ShellAlbert/PSU_Hirose_Version/README.md

# PSU_Hirose_Version
Power Supply Unit using Hirose Extensible Connector Version
