ShellAlbert/PSU_Hirose_Version/PSU_Hirose_Version/Schematic/SCH-PSU-Hirose.pdf

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
Here Vnormal=3.3V, Vcutoff=1.8V, t=10 seconds, I=100mA. C=[(Vnormal+Vcutoff)*I*t] / [(Vnormal^2-Vcutoff^2)] C=[(3.3+1.8)*0.1*10] / [3.3^2-1.8^2]=0.667F

## Farad Capacitor

The output voltage can be adjusted between 1.6V and 5.25V. Vout=1.004V*(R1/R2+1)=1.004V*(1M/270K+1)=4.72V

### LTC3105 400mA Step-Up DC/DC Converter Auxiliary 6mA LDO Regulator

Photovoltaic Cell

Photovoltaic Cell

VIN PIN
When used with high impedance sources such as photovoltaic cells, this pin should have a 10uF or larger decoupling capacitor.

MPPC PIN
Connect a resistor from MPPC to GND to program the activation point for MPPC loop. To disable the MPPC circuit, connect MPPC directly to GND.
VMPPC=10uA*RMPPC
=10uA*200K
=0.01mA*200K
=0.01A*200
=2V

THIS RESISTOR IS USED TO BYPASS AMP.

P5V0

### Vout=1.2V*(1+R2/R1) =1.2V*(1+1M/309K)

=5.08V

LTC3539
2A 1MHz Synchronous Step-Up DC/DC Converters VIN=0.7V~5V

## GAIN=1

ADA4051-1
1.8V,Micropower,Zero-Drift,
Rail-to-Rail Input/Output Op Amps 1/2Vcc | Input Independance >> 1M 1/3Vcc ADJ

## VCMP

# Open-Drain

## VCMP

OR

## OR Y=A|B

## AND Y=A&B

BIAS

Make sure IO is in tri-state during power up.

### MODE = High: Burst Mode operation at light loads, >=0.88V MODE = Low: Fixed frequency PWM Mode, <0.3V

CAUTION: No Polarity Protection Circuit Designed ! DIODES OR MOSFETS WILL CAUSE VOLTAGE DROP.

# IVC AMP

# BYPASS NOT

# CMP

LDO 2.2V/6mA
LDO22-1: UNIT GAIN AMP, HYSTERESIS VOLTAGE COMPARATOR, AND GATE LDO22-2: HYSTERESIS VOLTAGE COMPARATOR+OR GATE, OR GATE

OR

### AND

LED turns on at
I=(5.0-2.2)/56K=50uA

Vin_rise=Vref*(R1+R2)/R2
=1.0V*(160+300)/300
=1.53V

Vin_fall=(Vref*(R1+R2+Rpullup)-Vsupply*R1)/(R2+Rpullup) =(1.0v*(160+300+10000)-(2.2V*160))/(300+10000) =0.98

Since there's a 1/3 voltage divider before input,
the realistic action voltage are as follow ing Vin_rise=1.53V*3=4.59V
Vin_fall=0.98V*3=2.94V

Vin_rise=Vref*(R1+R2)/R2
=1.0V*(1000+5100)/5100
=1.2V

Vin_fall=(Vref*(R1+R2+Rpullup)-Vsupply*R1)/(R2+Rpullup) =(1.0v*(1000+5100+20000)-(2.2V*1000))/(5100+20000) =0.95V

Since there's a 1/2 voltage divider before input,
the realistic action voltage as follow ing Vin_rise=1.2V*2=2.4V
Vin_fall=0.95V*2=1.9V

# 1.9V(FALL) 2.4V(RISE)

# 2.94V(FALL) 4.59V(RISE)

L=Vout*(1-D)*T/(CR*Iout)
=5.0*(1-50%)*1uS/(30%*200mA) =4.2uH

Vfd=1.23V

Ve

R2

R1

R4

R3

Re

Rin

Appropriate Parameters
Case 1: R1=R2=R3=510, R4=560, Re=51, Rin=5.1K Case 2: R1=R2=R3=1K, R4=1.2K, Re=62, Rin=8.2K

CDONE,
Open-drain Output Configuration Done output. With weak pullup resistor to VCCIO_X.

# 1.8V IO

# SPI PROGRAMMING INTERFACE

# sysCONFIG Port / Pins

Horizontal-Short to Program Flash Vertical-Short to Program iCE

# OPEN-DRAIN PULL-UP

The sysCONFIG pins are dual function,
meaning they can be recovered as user I/O after configuration is complete.

# BUFFERING Octal RAM

2.0V

# ECL DRIVER CONNECT TO TMR/DPU DPU 1.8V IO

# POWER TO DPU

# RECEIVE: IVC->AMP->CMP

# OFFSET=1/2VCC

VTH SETTING

The maximum source/sink current of IOs are 4mA.

## (1.8V IO)

## (1.8V IO)

## (1.8V IO)

EXCLUSIVE
LD_PWR_EN FOR TMR
LD_PWR_EN_EXT FOR DPU

EXCLUSIVE
PSU_UART_TX FOR TMR
DPU_UART_TX FOR DPU

EXCLUSIVE
PSU_UART_RX FOR TMR
DPU_UART_RX FOR DPU

TMR SENSOR NEEDS 3.3 V POWER SUPPLY. DROP DOWN TO 2.8V IF IT'S COMPATIBLE.

Inductor peak current automatic adjusting to maximize efficiency 100mA at light load, 500mA at heavy load,
100mA to 500mA at intermediate loads.
This function is overridden by MPPC function.
Theoretically, maximum power output of photovoltaic cell is 250mW.
If we set VMPPC to maintain 2V, the peak inductor current is 250mW/2=125mA.

The MPPC circuit dynamically regulates the average inductor current to prevent the input voltage from dropping below the MPPC threshold. When Vin is greater than the MPPC voltage, the inductor current is increased until Vin is pulled down to the MPPC set point.
If Vin is less than the MPPC voltage, the inductor current is reduced until Vin rises to the MPPC set point.

LC LOW PASS FILTER
f-cutoff=1/(2*pi*sqrt(L*C)) =1/(2*3.1415*sqrt(10uH*22uF)=1073Hz

0R

0R

Jumpers used to cut off power supply of FPGA if it’s useless in realistic application.

# LTC3539 BOOST

P5V0

# MAX38650 BUCK

P1V8

# LTC3542 BUCK

# LTC3542 BUCK

# LASER DIODE TX&RX (ADJ)

# SENSOR(5V0) TMR(3V3) ULTRASONIC(3V3)

# iCE40UP5K FPGA

P2V8

# MAX38650 BUCK

P2V8

P1V8

### CONNECT TO VCAP

TO GET HIGHER EFFICIENCY.

P1V2

Estimate the maximum output current is 30mA, and the ripple current is 0.4*30mA=12mA, then L=Vout/(f*Delta IL)*(1-Vout/Vin(max))=2.8/(2.25*0.012)*(1-2.8/5)=45.6uH
L=Vout/(f*Delta IL)*(1-Vout/Vin(max))=3.3/(2.25*0.012)*(1-3.3/5)=41.6uH

## Vfd=2.2V

P5033

LED turns on at
I=(2.8-2.2)/12K=50uA

Vout=0.6V*(1+R2/R1)
=0.6V*(1+150K/33.2K)
=3.3V

# MAX38650 BUCK

P1V2

# P2V9ADJ

Vout=0.6V*(1+R2/R1)
=0.6V*(1+150K/39K)
=2.9V

LTC3542 Maximum Output Current is 500mA
A reasonable starting point for setting ripple current is Deal_IL=0.4*Iout(Max)=0.4*500=200mA The largest ripple current occurs at the maximum input voltage.
L=Vout/(f*Delta IL)*(1-Vout/Vin(max))
=1.8/(2.25*0.2)*(1-1.8/5)
=2.56uH
Actually we estimate the maximum output current is 30mA, and the ripple current is 0.4*30mA=12mA, then L=Vout/(f*Delta IL)*(1-Vout/Vin(max)) =1.8/(2.25*0.012)*(1-1.8/5)
=42.6uH RUN PIN
>1.5V: Enabled.
<0.3V: Disabled.

Enable Bypass Resistor to distribute P5V0.

P5033

# P2V9ADJ

# LOAD SWITCH

VFD=0.37V@20mA

RATING POWER OF DIFFERENT FOOTPRINTS 0402 : 1/16W (0.0625w)
0603 : 1/10W (0.1W)
0805 : 1/8W (0.125W)

H/C Type
Compatible
2F/5.5V

H/C Type
Compatible
2F/5.5V

### REMOVE R17 TO CUT OFF

ICE40 POWER SUPPLY.

# FRONT PANEL LED

UV_SHDN determines how low voltage the Farad capacitor can discharge. In heavy load application like cameras, slow down trigger voltage threshold. Present State:
UV_SHDN=1, Vin_rise=1.2V, Magnification Factor=2, 1.2V*2=2.4V, Vin>2.4V UV_SHDN=0, Vin_fall=0.95V, Magnification Factor=2, 0.95V*2=1.9V, Vin<1.9V Optimization:
My motivation is to slow down magnification factor from 2 to 1.1
Change Magnification Factor=1.1
Vin_rise=1.2V, 1.2V*1.1=1.32V
Vin_fall=0.95V, 0.95V*1.1=1.04V
For magnification factor=2, ½, R2/(R1+R2)=1/2, we choose R1=R2=1M-OHMS. For magnification factor=1.1, 1/1.1, R2/(R1+R2)=1.1, we choose R2=1M, get R1=? 1M/(R1+1M)=1.1, 1M/1.1=R1+1M, R1+1M=909090.90, R1=-90909.10
R1 is negative value !!!!!!
So the only way is to replace ADCMP380-1(1.0V VREF) with ADCMP3890-2(0.5V VREF). Vin_rise=Vref*(R1+R2)/R2=0.5V*(1000+5100)/5100=0.6V Vin_fall=(Vref*(R1+R2+Rpullup)-Vsupply*R1)/(R2+Rpullup) =(0.5*(1000+5100+20000)-(2.2*1000))/(5100+20000)
=0.432V
If the magnification factor of front stage is still 2, the trigger voltages are Vin_rise_action=0.6V*2=1.2V
Vin_fall_action=0.432V*2=0.864V
But the second boost converter LTC3539 can only work over 0.7V, this should grab our attention.

# CHARGING INDICATOR

# ADCMP380-1ACBZ-RL7, VRef=1.0V ADCMP380-2ACBZ-RL7, VRef=0.5V

# External Oscillator 12MHz->PLL->48MHz

IAM_ALIVE
IAM_ALIVE_EXT

IO_P5V0_SHDN_EXT

IO_P5V0_SHDN

PSU_UART_RX

DPU_UART_RX

## P1V8_DPU

## P2V8_DPU

## P3V3_DPU

LDO22-1

LDO22-2 VCAP

LDO22-2 VCAP

LDO22-2

LDO22-2

LDO22-2

LDO22-2 | LDO22-1
LDO22-1 | P1V8_RX

P1V8_RX

P1V8_RX

P1V8_RX

LDO22-1

VCAP

P1V20 | SPI_VCCIO1 P1V80 | P1V80 P1V20 | P1V80 P2V8 | P1V80 P1V80 VCCIO_0 P1V80 | P1V80 VCCIO_2 | P1V80 P1V80 | P1V80 | P1V80 P5V0

P2V8

P1V8 | P1V80 P1V2 | P1V20 P1V20
LDO22-1 | P¹V⁸_RX

P1V8_RX

P5V0

VCAP1 VCAP2 | P5V0 | P2V8 P1V8 P5V0 P5V0 P5V0 | P1V2 | P5033 P5V0 | P5033_PRE
P5V0 | P2V9ADJ P1V8ADJ_PRE

P2V9ADJ

P1V80 P2V9ADJ | P1V8_RX

VCAP

P5V0 VCAP

LDO22-2

P1V80 | P1V80
P5V0 | P5V0
P1V80 | P2V8 P1V80 P1V20 | P1V80
P5033 P2V8 | DPU_PWR_EN

DPU_PWR_EN

Title Size | Document Number | Rev Date: | Sheet | of PoF TINY DUAL CAMERA PROJECT | C2 PART ONE - POWER SUPPLY UNIT SCHEMATIC
A2 | Friday, September 26, 2025 | 1 | 1 Title Size | Document Number | Rev Date: | Sheet | of PoF TINY DUAL CAMERA PROJECT | C2 PART ONE - POWER SUPPLY UNIT SCHEMATIC
A2 | Friday, September 26, 2025 | 1 | 1 Title Size | Document Number | Rev Date: | Sheet | of PoF TINY DUAL CAMERA PROJECT | C2 PART ONE - POWER SUPPLY UNIT SCHEMATIC
A2 | Friday, September 26, 2025 | 1 | 1

D5GREEN LED R³⁰ DNI

TP2 C510uF C78

22uF C6810uF | R31 | 0 | R113

10K

R128 DNP | Q6 | MMBT2222ALT1G

FB3

BLM15PX121SN1D

L8

2.2uH

C42 | 0.1uF
TP15 | R89 33.2K

U17

SN74LVC1G32DBVR 1 | C10096 A

### 2 B

### 3 GND

### 4 Y

### 5 VCC

R108 0

R36

200K

# C47 0.1uF R41 1M

R114 6.8K

C8 CEN5R5205HF-ZG

1 2

3 4

R26 | 10K | C49

10uF C56

0.1uF

# TP12 R62

270K

R67 0

C35

10uF

L6 | 10uH/1A C177242 | R80 DNI
R6 | 1K

R47
1M | R⁵⁴ 4.7K

R58
510

C26

10uF | C90.1uF

L11 47uH/100mA

# J3 CONN-2X15P

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
D3GREEN LED

R101 10K

U22 | SN74LVC1G32DBVR

C10096 1 A

### 2 B

### 3 GND

### 4 Y

### 5 VCC

C17
0.1uF

R33 150K R¹⁰⁶

0

C43

0.1uF | R103 DNP C100.1uF
R102 10K | R130 DNP

Y1 12.0MHz EN

### 1 GND

### 2 OUT

### 3 VCC

4 R82 | 0 R¹⁵ 0 | D4 GREEN LED
C130723 R46 | 0

Q4

BFR93AWH6327 | B1

### 3 C

2E

# TP8 Solar Cell V- R42

2M

R110 10K R120 11.8K

TP4

TP6 | R127 | 0 Q1 | MMBT2222ALT1G

R8
51

U1 TXS0102DCUR
B2

### 1 GND 2 VCCA 3 A2 4 A1

### 5 OE

### 6 VCCB

7 B1 C4 | 8 10uF

U21 LTC3539EDCB-2#TRPBF SW

### 1 PGND

### 2 GND

# 3 VIN

### 4 SHDN

### 5 FB

### 6 MODE

### 7 VOUT

### 8 EPAD

### 9 C62

0.1uF

R3 | 0 | C79
| | 47uF

R48
270K

R28 0

R87 0

L9 | 2.2uH
R83 | 12K
R99 DNI | C63 | 0.47uF
L7 | 2.2uH
R93 | DNP
L10 | 4.7uH/200mA | R78 0 C36
1uF | R123 0 R60

20K R90

10K

R86 DNI

R38
1M
L3 | 2.2uH/200mA R27 | DNI

R52

### 51 D6 GREEN LED

C130723

R91 100K

C65
0.1uF

TP7 C20

47uF

R75 | 0 | R¹¹⁸
U20 | DNI

SN74AUP1G08DBVR

C139409 VCC

### 5 GND

### 3 A

### 1 B

### 2 Y

4 | R68 | DNP | C22 | 22pF
R95 | 2.2K
R50 | 100K

R121 DNP R61

200K

R21 | 0 | R25 | DNP

C60.1uF

Q7 MMBT2222ALT1G

C37

0.1uF | C25 | 0.1uF

TP9 Solar Cell V+

R22 DNP

C14

47uF

R23 DNP

Q2 MMBT2222ALT1G

## FB5BLM¹⁵PX¹²¹SN¹D

R17 | DNP | C73 | 1.5pF R112 1K | C64

0.1uF

R51 | 1K | R⁹⁴ 10K R122 DNP

C7 CEN5R5205HF-ZG

1 2

3 4 R104 2K

R79 160

C45

10nF C27

10nF | R⁴ 20K | R7 | 1K
TP3 | R¹⁶ 0 | R10 | 0
C59

# 22uF U2

LTC3542ES6 VIN

### 1 GND

### 2 VFB

### 3 RUN

### 4 MODE/SYNC

### 5 SW

6

L12 0R

R129 DNP

TP10 Solar Cell V+

C19

47uF R88 150K

R56
1M
R115

# 1M R⁴⁴ DNI

C74

22uF

LD1 LaserDiode
LD+

1
LD- 2 | PD- | 3 PD+

4

D9 GREEN LED C130723

C40

22uF

C75

0.1uF

C71

10uF | U15 LTC3105EDD#PBF

FB

1

LDO

### 2 FBLDO

### 3 SHDN

### 4 MPPC

# 5 VIN

### 6 SW

### 7 PGOOD

### 8 VOUT

### 9 AUX

10 11 GND

R109

309K

R13 | DNP
R84 | 0 | C31
10nF C2910uF | R100 0
TP14 | R131 DNP
C60 | 0.1uF U13 | ADA4051-2ARMZ C160715

### 1 OUT A -IN A

2 +IN A
3

### 4 V-8 V+ OUT B 7

-IN B

6 +IN B

5

R63 | 0
R12 | 1K
FB4 BLM15PX121SN1D | R⁹⁷ 10K R126 DNP

# J2 CONN-1X8

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
0.1uF | R² 20K
D7 GREEN LED C130723 | R57 | 40.2K | C18
0.1uF | C53

0.1uF

R125 DNP

## FB2BLM¹⁵PX¹²¹SN¹D

R53 | DNP
R107 0 | R34 | DNP

C38

10nF

R32
39K
C46 | 2.2uF
R40 | 1K | R⁷³ 6.8K

C48

10uF C54 | 2.2uF | C2

0.1uF

REF

+

- U16 | ADCMP380-(1/2)ACBZ-RL7 A¹ VCC GND A² B1 EN | GND B²

IN

C1 | OUT C2
R70 | DNP

REF

+

- U18 | ADCMP380-(1/2)ACBZ-RL7 A¹ VCC GND A² B1 EN | GND B²

IN

C1 | OUT C2
R72 | 0 | C41 | 0.1uF C58

10uF U14 LTC3105EDD#PBF

FB

1

LDO

### 2 FBLDO

### 3 SHDN

### 4 MPPC

# 5 VIN

### 6 SW

### 7 PGOOD

### 8 VOUT

### 9 AUX

10 11 GND

R1

20K | C69

0.1uF R37
1M

R98

0

C13
0.1uF

C32

0.1uF

C70

33pF

R105 0 | C11
0.1uF C76 | 0.1uF

U6 W25Q32JVZPIQ/WSON-8 CS

1 | DO(IO1) 2 | WP(IO2) 3 | GND
DI(IO0) | 4

### 5 CLK

6 | HLD/RST(IO3) 7 | VCC

8

R66
510
C12 | 0.1uF
L4 | 2.2uH/200mA | R119 | 10K
TP13 | R117 0 R²⁰ 0 | R⁶⁴ 10K C44
0.1uF U9 | MAX38650AANT+ A²
IN | LX A1 | OUT B2 EN
B1 | RSEL | B3 A³ GND | R⁵ 20K | U11 OPA320AIDBVR OUT

### 1 V⁻ 2

IN+

3

IN- 4 V⁺

# 5 C51

10nF

J4 DF40HC(3.0)-70DS-0.4V(51)

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
22pF

R85
300 C16

0.1uF

C61

0.1uF

L1 47uH/200mA

TP1

R74 | 3.3K | R⁶⁹ 6.8K

C39

22pF

R76 | 3.3K | C3

10uF

U3 | MAX38650AANT+ A²
IN | LX A1 | OUT B2 EN
B1 | RSEL | B3 A³ GND
C55 | 22pF | R19 | DNP D1 GREEN LED
C130723 | R¹⁸ DNP
L5 | 10uH/1A C177242 R49
5.1K | D2GREEN LED

C66

10uF | C80 | DNP
C67 | 0.1uF

R45

510 Q3 MMBT2222ALT1G

C77

22uF

U19
LTC3542ES6 VIN

### 1 GND

### 2 VFB

### 3 RUN

### 4 MODE/SYNC

### 5 SW

### 6 R²⁹ DNP

R124 100K | U12

LMV7291MGX/NOPB VOUT

1 | V⁻ 2 | +IN

3

| | -IN

### 4 V⁺

# 5 iCE40UP5K - SG48Bank1 Bank0 Bank2

iCE40UP5K- SG48

U5

C2678152 | IOB_0A

46

IOB_2A

47
IOB_3B_G6

44

IOB_4A

48
IOB_5B

45

IOB_6A

2

IOB_8A

4
IOB_9B

# 3 CRESET_B

### 8 CDONE

7

IOB_13B

6

IOB_16A

9

IOB_18A

### 10 IOB_20A

11

IOB_22A

12
IOB_23B

21
IOB_24A

13
IOB_25B_G3

20
IOB_29B

19
IOB_31B

18

IOB_32A_SPI_SO

### 14 IOB_33B_SPI_SI 17 IOB_34A_SPI_SCK

### 15 IOB_35B_SPI_SS

### 16 VCCPLL

29

IOT_36B

### 25 IOT_37A

23

IOT_38B

### 27 IOT_39A

26

IOT_41A

28

IOT_42B

### 31 IOT_43A

32

IOT_44B

### 34 IOT_45A_G1

37

IOT_46B_G0

35

IOT_48B

### 36 IOT_49A

43

IOT_50B

### 38 IOT_51A

### 42 RGB0

### 39 RGB1 40 RGB2

# 41 GND 49 VCC

### 5 VCC

# 30 VCCIO_0

### 33 SPI_VCCIO1

# 22 VCCIO_2

### 1 VPP_2V5

### 24 R43

100R

# J5 CONN-2X15P

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
0.1uF | R116 0

Q5

BFR93AWH6327 1B

### 3 C

2E

C21

10uF

C1 | 0.1uF | R59 | 0

R111 DNP

R96 DNI

U4 APS25608N-OBR-BD
RST A4 | CE
A3 | | | | | | | | | CLK
B2 | A/DQ0 D3 | A/DQ1 D2 | A/DQ2 C4 | A/DQ3 D4 | A/DQ4 D5 | A/DQ5 E3 | A/DQ6 E2 | A/DQ7 E1 | DQS/SM
C3 | VDD
D1 VSS | C1 VDD

# E4 VSS

E5 NC.A2 | A2 NC.A5 | A5 NC.B1 | B1 NC.B3 | B3 NC.B4 | B4 NC.B5 | B5 RFU
C2 NC.C5 | C5

C23

10uF

R14 | 20K | R⁸¹ 10K

# J1 CONN-1X8

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
### 9 D8

1N5819WT

L2 2.2uH/200mA C34

10uF

## PD1Photodiode

1 2

R92 20K

U10 OPA320AIDBVROUT

### 1 V⁻ 2

IN+

3

IN- 4 V⁺

5

C33

1uF

C15
0.1uF
TP5 | C52

0.1uF C57

10nF

R24 | 10K
R71 | DNP | R⁶⁵ 6.8K
U7 | MAX38650AANT+ A²
IN | LX A1 | OUT B2 EN
B1 | RSEL | B3 A³ GND

TP11 Solar Cell V-

C72

0.1uF U8 TPS22995HQDDCRQ1 VIN

### 2 VBIAS 1 ON 3 GND

RT 4

### 6 VOUT

### 5 R⁵⁵ 4.7K

## FB1BLM¹⁵PX¹²¹SN¹D

R11 1K

R9
20K

R77 510

## C5010uF

R35 0R

R39
510

TP16 UV_SHDN

CHG_FULL | 1ST_EN

BIO-8

LOCK_EN

FP2_SO | FL2_MOSI FL2_MISO | FP2_SI FF2_SS | FF2_SS
FF2_SCK | FF2_SCK
FP2_SI | FL2_MOSI FP2_SO | FL2_MISO

FL2_WP
FP2_RST | FL2_RST
FP2_DONE

BIO-3
IOB_23B
BIO-1 EXT_24MHz PSU_UART_TX
LD_PWR_EN | DONE2_LED
BIO-5 BIO-4 BIO-6
IOT_37A | BIO-7 | FP2_SI EIO-2 | FF2_SS
EIO-6 | FF2_SCK
EIO-4 | FP2_SO
EIO-1 EIO-8 RAM_RST EIO-5 RAM_ADQ1 | BIO-8 BIO-9 RAM_ADQ2 | RAM_ADQ6 RAM_DQS | RAM_ADQ3 EIO-7 | RAM_ADQ5 RAM_CLK | RAM_ADQ4 RAM_ADQ0 RAM_ADQ7

LED0
LED1
LED2 | RAM_RST RAM_CE RAM_CLK RAM_ADQ0 RAM_ADQ1 RAM_ADQ2 RAM_ADQ3 RAM_ADQ4 RAM_ADQ5 RAM_ADQ6 RAM_ADQ7 RAM_DQS

LED0

LED1

LED2 BIO-1 BIO-3 | SIG_ALIVE

RAM_CE

BIO-9 | FP2_RST

PSU_UART_TX

EIO-6 | BIO-6 BIO-7

LD_PWR_EN

EIO-8 | RX_PWR_EN

RX_PWR_EN

1ST_EN
LOCK_EN

LED1
LED0

EXT_24MHz

BIO-2 | BIO-9
IOT_37A

# EIO-6 EIO-7 EIO-1

IOT_37A

EIO-2

EIO-5 EIO-5 EIO-8 EIO-4 EIO-2 | BIO-1 BIO-3 BIO-5 BIO-4 BIO-6 BIO-7 BIO-8
