ShellAlbert/PSU_Hirose_Version/PSU_Hirose_Version/Fabrication_History/PSU_C2_6Layers_90x30mm/SMT/BOM_OF_PSU_C2.xlsx

1. 所有电容都要求16V以上耐压。 2. 大部分元器件在立创商城上都有货，其他的在Mouser.cn上有现货。
Item | Quantity | Reference | Part | PCBFootprint
1 | 33 | C1,C2,C4,C7,C10,C11,C12,C13,C15,C21,C22,C25,C35,C37,C38,C39,C41,C43,C46,C50,C51,C55,C56,C57,C59,C61,C63,C65,C68,C69,C70,C71,C76 | 0.1uF | C0402_SMT | 贴片电容，0402封装
2 | 14 | C3,C18,C20,C23,C27,C30,C31,C44,C47,C52,C54,C58,C60,C64 | 10uF | C0603_SMT | 贴片电容，0603封装
3 | 2 | C5,C6 | CEN5R5205HF-ZG | SUC_C_5D0_21D5_H_20D5 | CDA(智烽维) 5.5V 2F超级电容
4 | 1 | C8 | 0.47uF | C0402_SMT | 贴片电容，0402封装
5 | 6 | C9,C24,C26,C36,C40,C45 | 10nF | C0402_SMT | 贴片电容，0402封装
6 | 4 | C14,C16,C17,C74 | 47uF | C1206 | 贴片电容，1206封装
7 | 4 | C19,C28,C33,C49 | 22pF | C0402_SMT | 贴片电容，0402封装
8 | 2 | C29,C32 | 1uF | C0402_SMT | 贴片电容，0402封装
9 | 5 | C34,C53,C67,C72,C73 | 22uF | C1206 | 贴片电容，1206封装
10 | 2 | C42,C48 | 2.2uF | C0402_SMT | 贴片电容，0402封装
11 | 1 | C62 | 33pF | C0402_SMT | 贴片电容，0402封装
12 | 1 | C66 | 1.5pF | C0402_SMT | 贴片电容，0402封装
13 | 8 | D1,D2,D3,D4,D5,D6,D8,D9 | GREEN LED | LED0402_SMT | 贴片发光二极管/LED，绿色
14 | 1 | D7 | 1N5819WT | SOD-523 | 肖特基二极管
15 | 5 | FB1,FB2,FB3,FB4,FB5 | BLM15PX121SN1D | L0402_SMT | muRata(村田)磁珠120Ω@100MHz，0402封装
16 | 2 | J1,J4 | CONN-1X8 | FPC-0D5-8P | FPC连接器8Pins,SMD,P=0.5mm,卧贴翻盖式下接
17 | 2 | J2,J3 | CONN-24P | SMD_CONN_2X12P_1D27 | 贴片排针2x12P,SMD,P=1.27mm
18 | 1 | L1 | 47uH/200mA | IND_SMD_4D4X4D2 | 长江微电,SMD功率电感，4x4x3mm, FNR4030S470MT
19 | 3 | L2,L3,L4 | 2.2uH/200mA | IND_SMD_4D4X4D2 | 长江微电,SMD功率电感,4.2x4.4mm, FXL0420-2R2-M
20 | 2 | L5,L6 | 10uH/1A | IND_SMD_4D4X4D2 | 长江微电,SMD功率电感，4x4x2mm, FHD4020S-100MT
21 | 3 | L7,L8,L9 | 2.2uH | L0402 | muRata(村田)贴片电感170mA, LQW15CN2R2M10D
22 | 1 | L10 | 4.7uH/200mA | IND_SMD_4D4X4D2 | 长江微电,SMD功率电感，4x4x3mm, FNR4030S4R7MT
23 | 1 | L11 | 47uH/100mA | IND_SMD_4D4X4D2 | 长江微电,SMD功率电感，4x4x3mm, FNR4030S470MT
24 | 1 | L12 | 0R | L0603 | 该电感用0R电阻替代
25 | 2 | Q1,Q2 | BFR93AWH6327 | SOT23-3 | Infineon(英飞凌) NPN 三极管
26 | 5 | Q3,Q4,Q5,Q6,Q7 | MMBT2222ALT1G | SOT-23-3 | 安森美 NPN 三极管
27 | 8 | R1,R3,R4,R5,R9,R60,R84,R127 | 20K | R0402_SMT | 贴片电阻，0402封装
28 | 30 | R2,R10,R17,R21,R22,R26,R34,R47,R59,R63,R65,R69,R70,R73,R74,R78,R88,R90,R91,R96,R97,R99,R106,R107,R109,R114,R119,R121,R125,R126 | 0R | R0402_SMT | 贴片电阻，0402封装
29 | 7 | R6,R7,R8,R42,R54,R102,R128 | 1K | R0402_SMT | 贴片电阻，0402封装
30 | 2 | R11,R32 | 51R | R0402_SMT | 贴片电阻，0402封装
31 | 4 | R12,R13,R14,R104 | 6.8K | R0402_SMT | 贴片电阻，0402封装
32 | 11 | R18,R45,R51,R68,R77,R82,R92,R93,R110,R111,R116 | 10K | R0402_SMT | 贴片电阻，0402封装
33 | 5 | R29,R31,R33,R35,R50 | 510R | R0402_SMT | 贴片电阻，0402封装
34 | 1 | R36 | 39K | R0402_SMT | 贴片电阻，0402封装
35 | 2 | R37,R80 | 150K | R0402_SMT | 贴片电阻，0402封装
36 | 2 | R38,R61 | 200K | R0402_SMT | 贴片电阻，0402封装
37 | 6 | R39,R40,R43,R48,R56,R105 | 1M | R0402_SMT | 贴片电阻，0402封装
38 | 1 | R41 | 100R | R0402_SMT | 贴片电阻，0402封装
39 | 1 | R44 | 2M | R0402_SMT | 贴片电阻，0402封装
40 | 2 | R49,R62 | 270K | R0402_SMT | 贴片电阻，0402封装
41 | 1 | R52 | 5.1K | R0402_SMT | 贴片电阻，0402封装
42 | 4 | R53,R83,R103,R120 | 100K | R0402_SMT | 贴片电阻，0402封装
43 | 2 | R55,R57 | 4.7K | R0402_SMT | 贴片电阻，0402封装
44 | 1 | R58 | 40.2K | R0402_SMT | 贴片电阻，0402封装
45 | 2 | R67,R71 | 3.3K | R0402_SMT | 贴片电阻，0402封装
46 | 1 | R72 | 160R | R0402_SMT | 贴片电阻，0402封装
47 | 1 | R75 | 12K | R0402_SMT | 贴片电阻，0402封装
48 | 1 | R79 | 300R | R0402_SMT | 贴片电阻，0402封装
49 | 1 | R81 | 33.2K | R0402_SMT | 贴片电阻，0402封装
50 | 1 | R86 | 2.2K | R0402_SMT | 贴片电阻，0402封装
51 | 1 | R95 | 2K | R0402_SMT | 贴片电阻，0402封装
52 | 1 | R98 | 309K | R0402_SMT | 贴片电阻，0402封装
53 | 1 | R112 | 11.8K | R0402_SMT | 贴片电阻，0402封装
54 | 2 | U1,U19 | LTC3542ES6 | TSOT-23-6 | ADI(亚德诺)DC-DC电源芯片降压型
55 | 3 | U2,U6,U8 | MAX38650AANT+ | WLP-6 | ADI开关稳压器 NanoPower Buck Converter
56 | 1 | U3 | APS25608N-OBR-BD | BGA-24 | AP Memory动态随机存取存储器
57 | 1 | U4 | iCE40UP5K- SG48 | QFN-48 | FPGA - 现场可编程门阵列 iCE40 UltraPlus, 5280 LUTs, 1.2V
58 | 1 | U5 | W25Q64JWSSIQ | SOIC-8 | Winbond NOR闪存 spiFlash, 64M-bit, 4Kb Uniform Sector
59 | 1 | U7 | TPS22995HQDDCRQ1 | SOT-23-6 | Texas Instruments负载开关
60 | 1 | U9 | SN74LVC1G14DBVR | SOT-23-5 | Texas Instruments反相器
61 | 1 | U10 | LMV7291MGX/NOPB | SC70-5 | TI(德州仪器)比较器
62 | 2 | U11,U12 | OPA320AIDBVR | SOT-23-5 | TI(德州仪器)单路20MHz精密运放
63 | 1 | U13 | ADA4051-2ARMZ | MSOP-8 | ADI(亚德诺)双路 运算放大器
64 | 2 | U14,U15 | LTC3105EDD#PBF | DFN-10 | ADI(亚德诺)DC-DC电源芯片升压式
65 | 2 | U16,U18 | ADCMP380-(1/2)ACBZ-RL7 | WLCSP-6 | ADI(亚德诺)比较器
66 | 2 | U17,U22 | SN74LVC1G32DBVR | SOT-23-5 | TI(德州仪器)逻辑门或门
67 | 1 | U20 | SN74AUP1G08DBVR | SOT-23-5 | TI(德州仪器)逻辑门与门
68 | 1 | U21 | LTC3539EDCB-2#TRPBF | DFN-8 | ADI(亚德诺)DC-DC电源芯片升压型
