ShellAlbert/PSU_Hirose_Version/(list of files, drawings)

Other design files:
PSU_Hirose_Version/Schematic/LIBRARY1.OLB
PSU_Hirose_Version/Schematic/PSU.DSN
PSU_Hirose_Version/Schematic/PSU.opj
