ShellAlbert/PSU_Hirose_Version/(commit log)

2025-10-22 PSU Hirose Extensible Connector Version
    [BOM_OF_PSU_C2.xlsx, BOM_OF_PSU_HIROSE.xlsx, LIBRARY1.OLB, PSU.DSN, PSU.opj, PSU_Hirose_PickAndPlace_XY.xlsx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]
2025-10-22 eliminate temporary files
    [cases.cfg]
